ZiGaMi/SleepMonitor2.0_PROJECT_OUTPUTS/README.md

# SleepMonitor2.0_PROJECT_OUTPUTS
Project outputs repository for SleepMonitor 2.0
