ZiGaMi/SleepMonitor2.0_PROJECT_OUTPUTS/PCB/REV2.0/Sleep_Monitor_V2_0_SCH.pdf

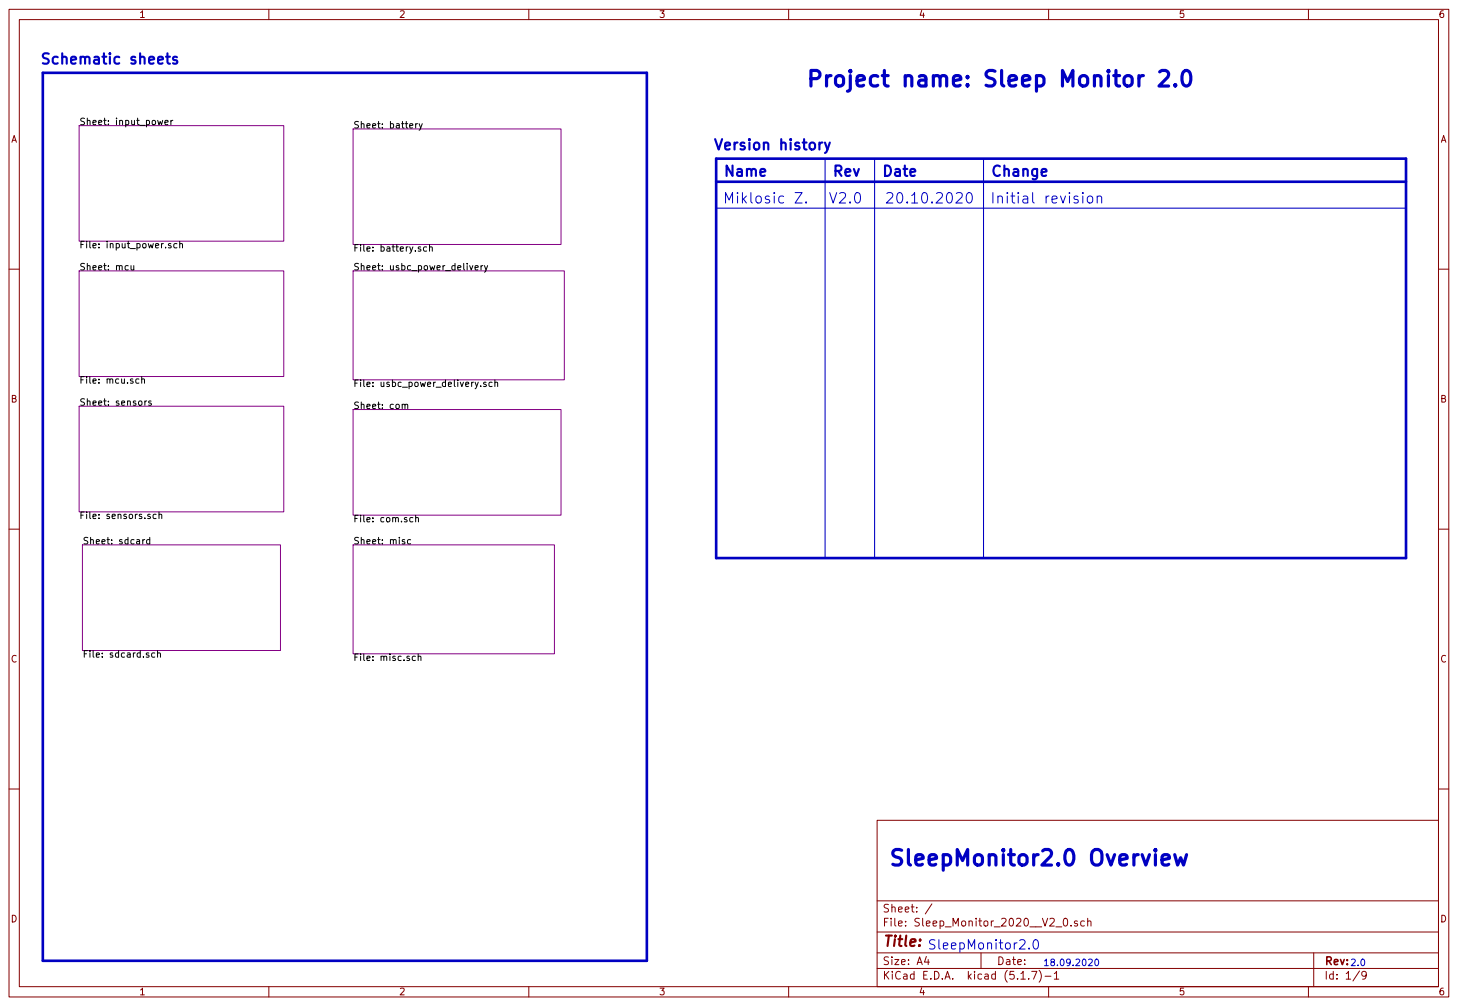
[picture p1: page 1]

Project name: Sleep Monitor 2.0

File: usbc_power_delivery.sch Sheet: com

File: com.sch Sheet: sdcard File: sdcard.sch

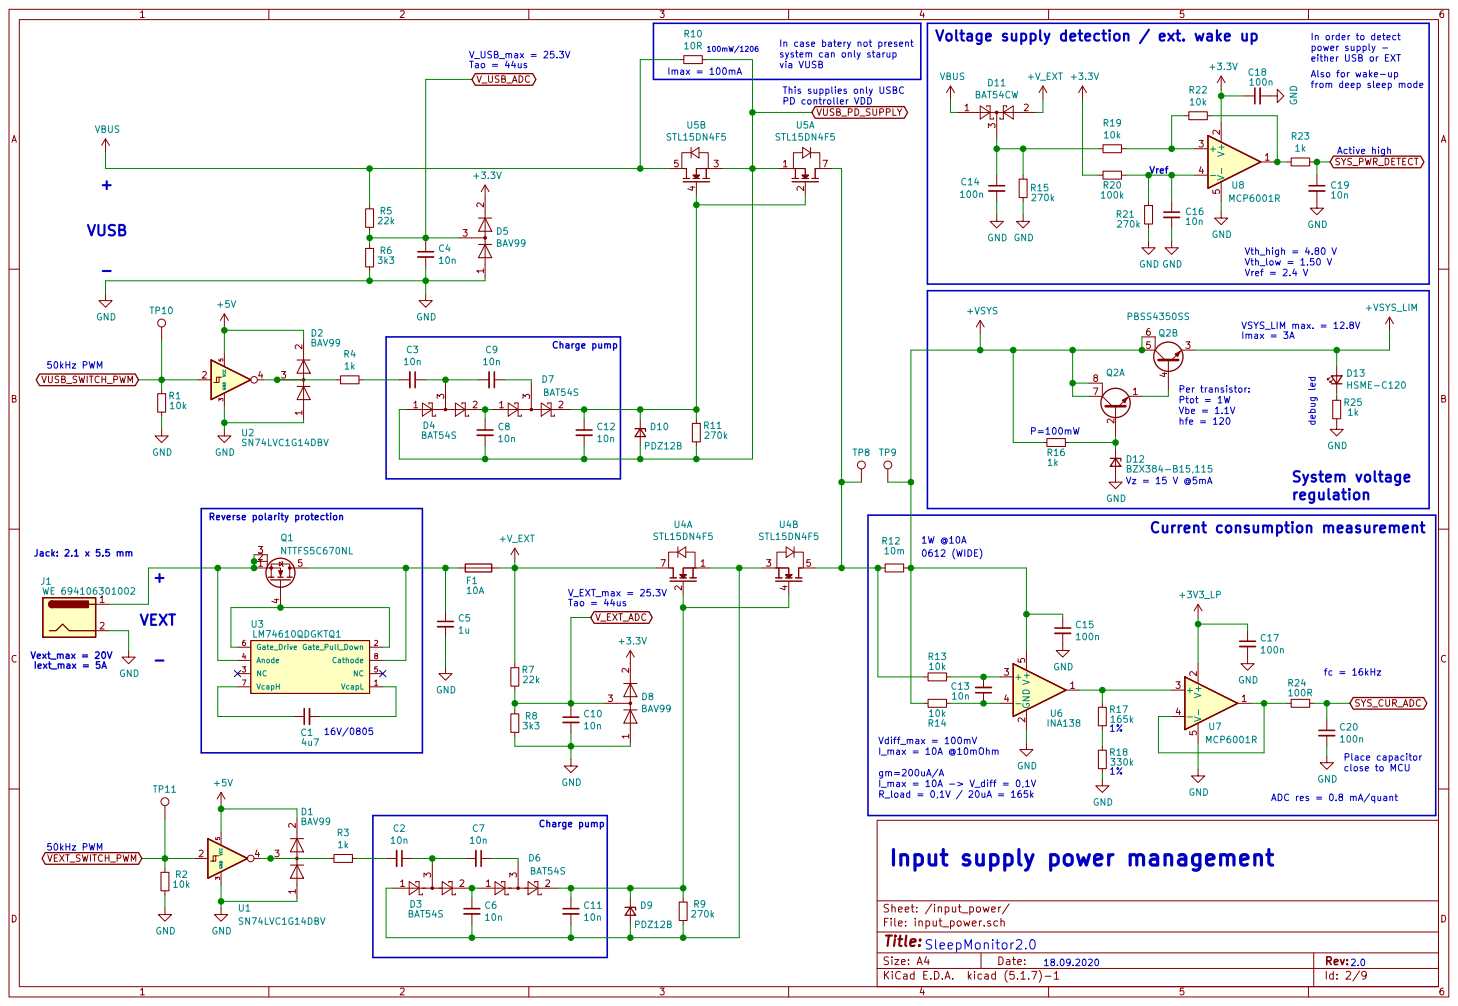
[picture p2: page 2]

In case batery not present
system can only starup
via VUSB

Also for wake-up
from deep sleep mode

This supplies only USBC
PD controller VDD

Place capacitor close to MCU

ADC res = 0.8 mA/quant

Input supply power management

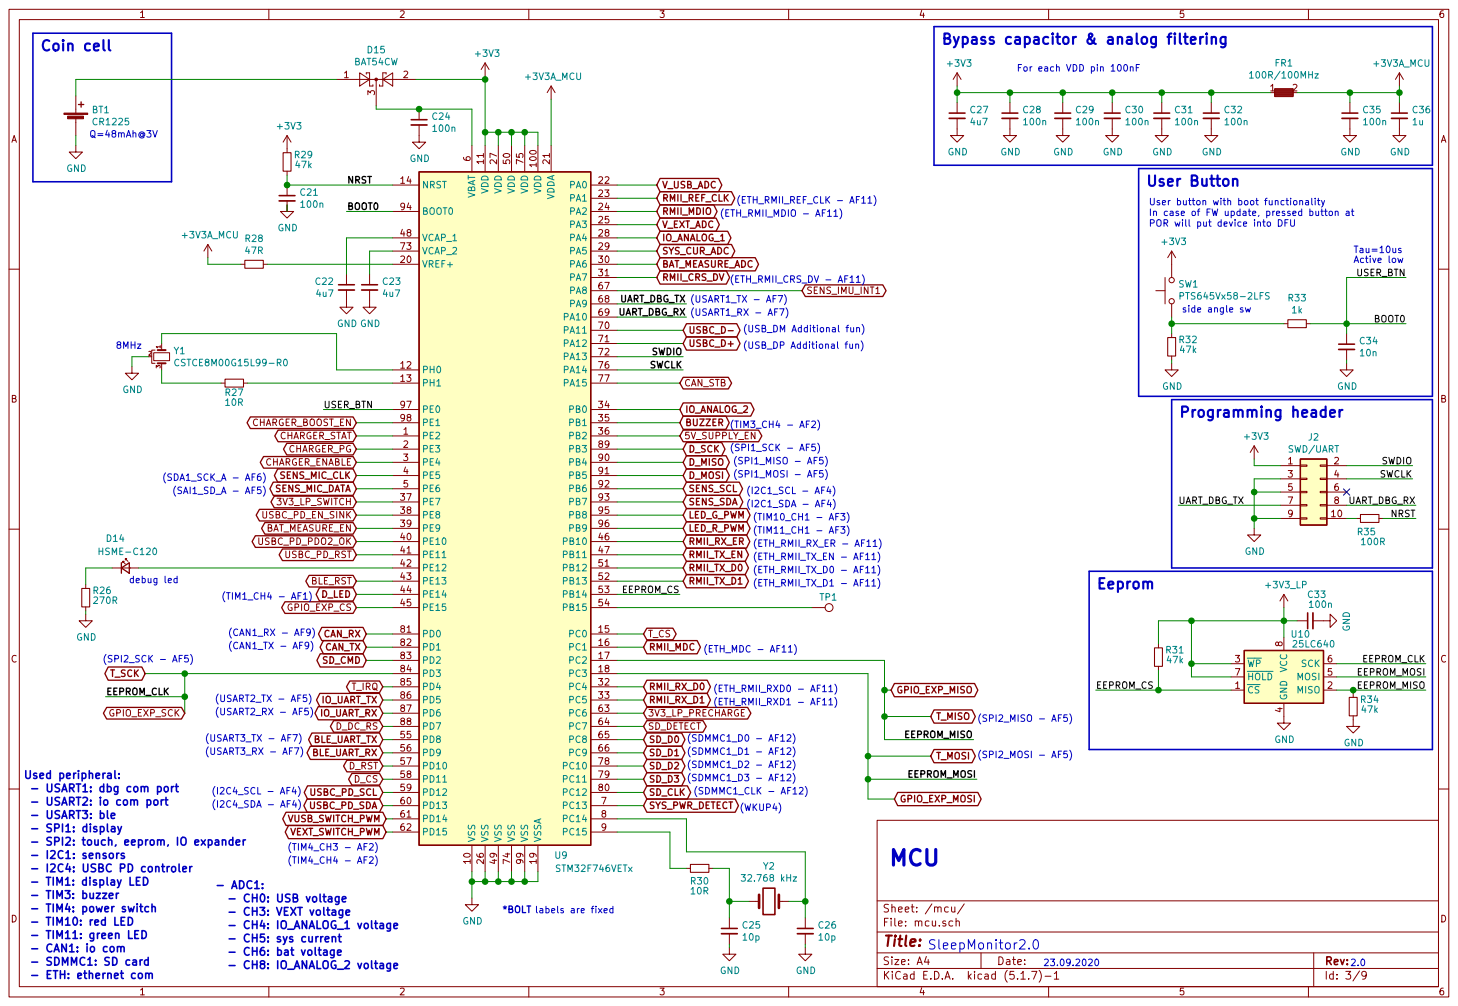
[picture p3: page 3]

Bypass capacitor & analog filtering

For each VDD pin 100nF

6 VCAP_1 48 VCAP_2 73 VDD 100 VDD 11 VDD 27 VDD 50 VDD 75 VDDA 21 VREF+ 20 VSS 10 VSS 26 VSS 49 VSS 74 VSS 99 VSSA 19U9STM32F746VETx

User button with boot functionality
In case of FW update, pressed button at
POR will put device into DFU

4 MOSI 5 SCK 6 HOLD 7 VCC

Used peripheral:
- USART1: dbg com port
- USART2: io com port
- USART3: ble
- SPI1: display
- SPI2: touch, eeprom, IO expander
- I2C1: sensors
- I2C4: USBC PD controler
- TIM1: display LED
- TIM3: buzzer
- TIM4: power switch
- TIM10: red LED
- TIM11: green LED
- CAN1: io com
- SDMMC1: SD card
- ETH: ethernet com

Id: 3/9 Title: File: mcu.sch Sheet: /mcu/
SleepMonitor2.0

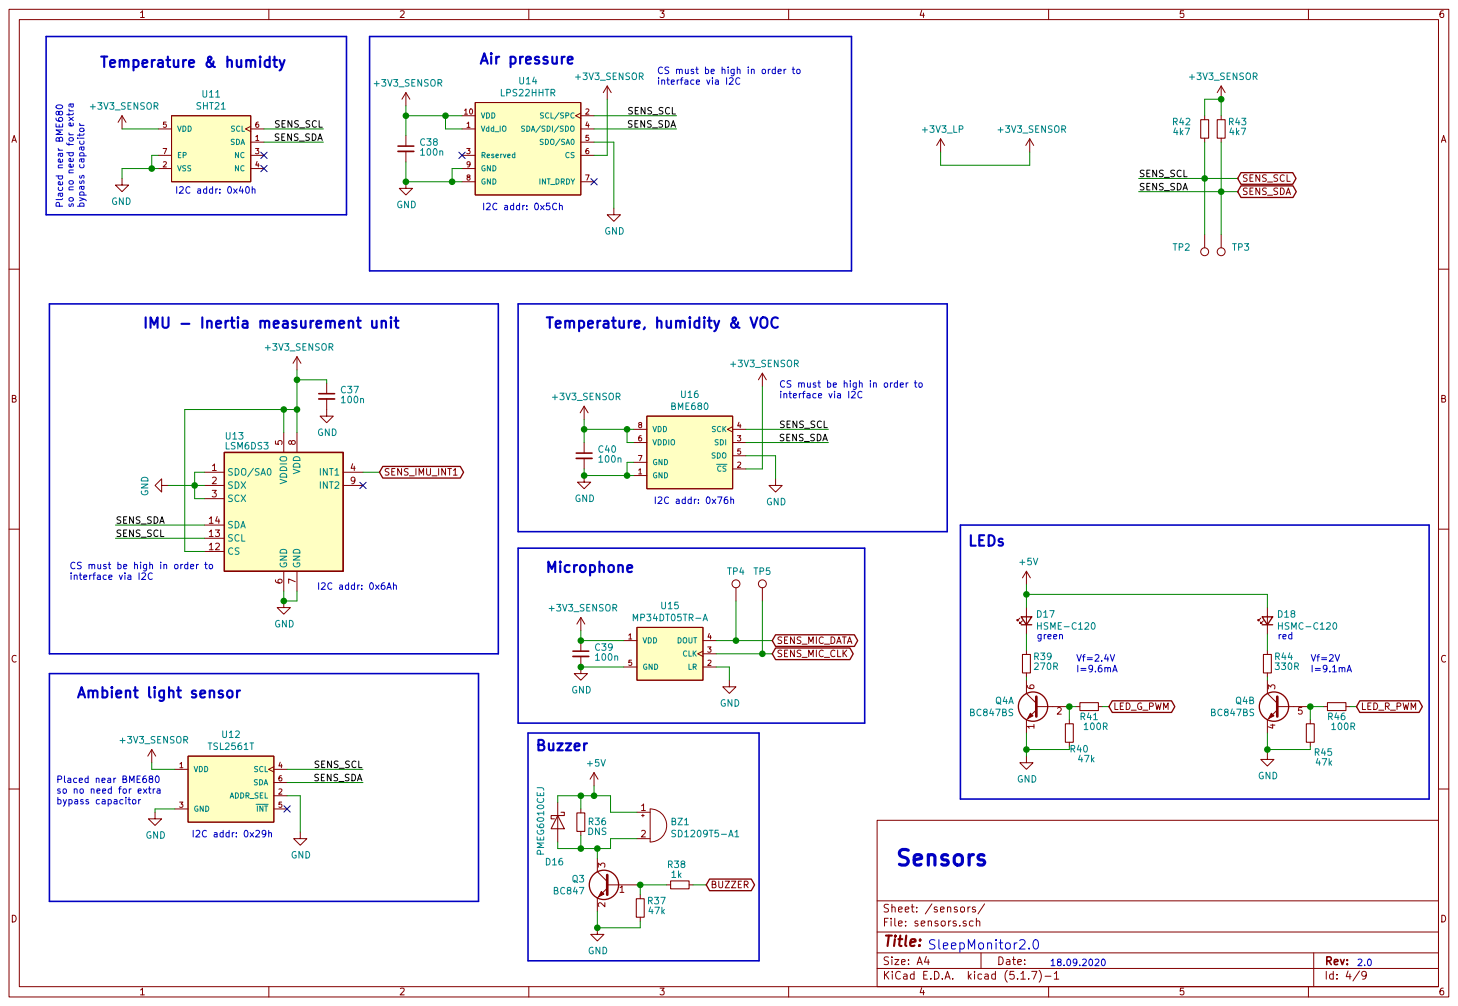
[picture p4: page 4]

interface via I2C Air pressure
+3V3_SENSOR GND

CS must be high in order to

SleepMonitor2.0 Placed near BME680 so no need for extra bypass capacitor Placed near BME680

IMU - Inertia measurement unit

I2C addr: 0x76h Temperature, humidity & VOC

interface via I2C

Ambient light sensor

Sensors | GND Id: 4/9 Title: File: sensors.sch Sheet: /sensors/

so no need for extra
bypass capacitor

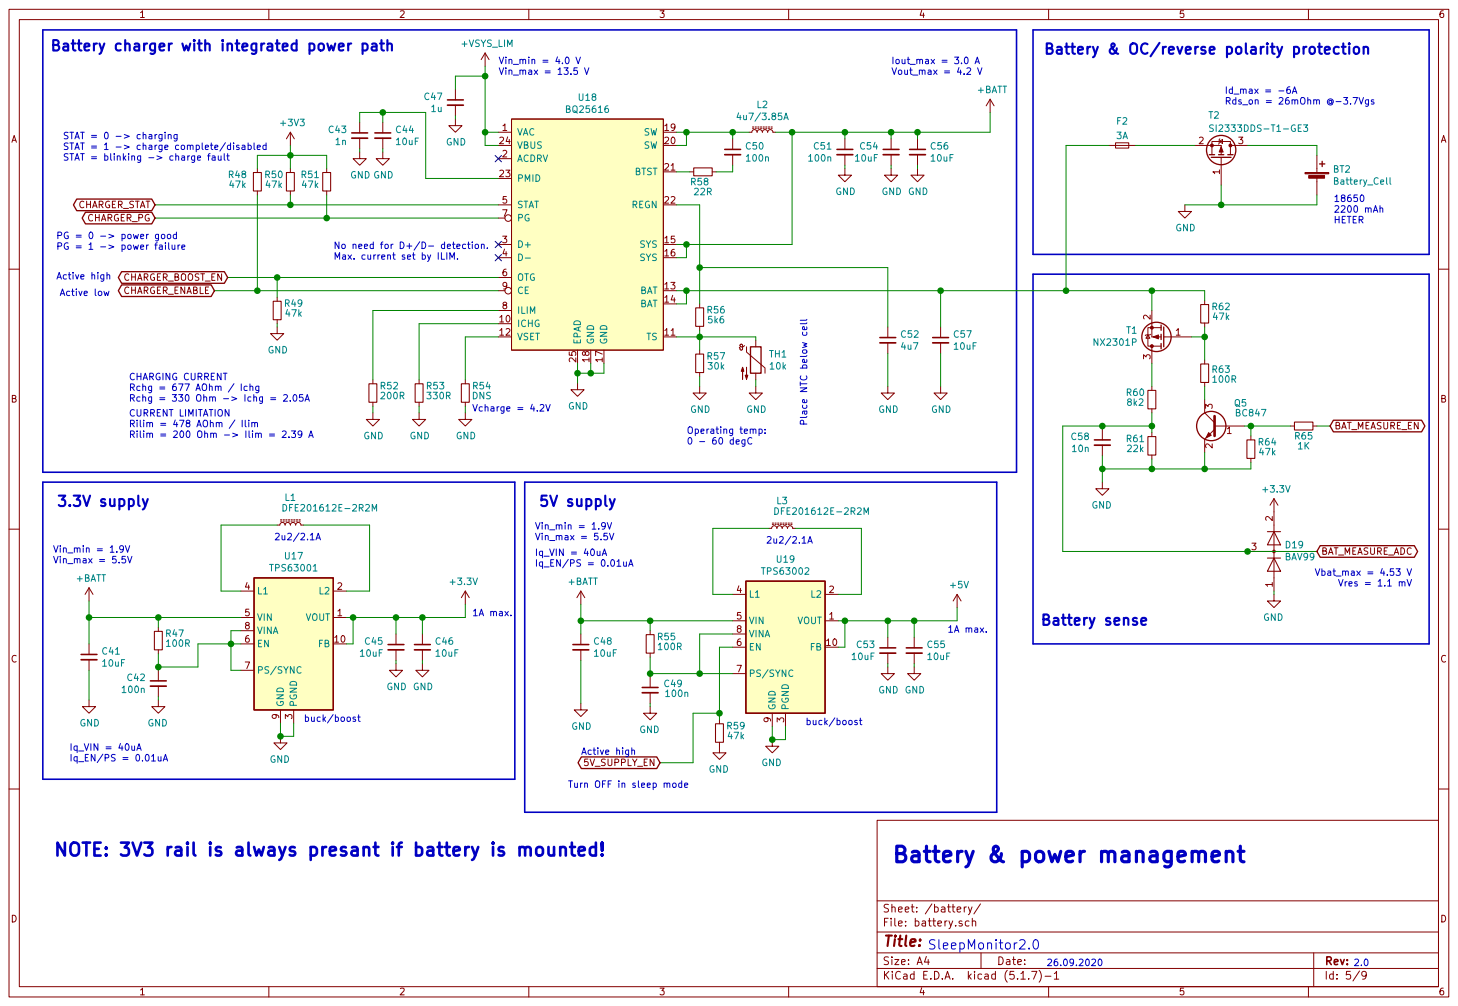
[picture p5: page 5]

Battery charger with integrated power path

Battery & OC/reverse polarity protection Place NTC below cell

STAT = 0 -> charging
STAT = 1 -> charge complete/disabled
STAT = blinking -> charge fault
10uF GND

Vcharge = 4.2V No need for D+/D- detection. Max. current set by ILIM.

Active high Active low

2u2/2.1A CHARGING CURRENT Rchg = 677 AOhm / Ichg

buck/boost Operating temp:
0 - 60 degC

Turn OFF in sleep mode

NOTE: 3V3 rail is always presant if battery is mounted!

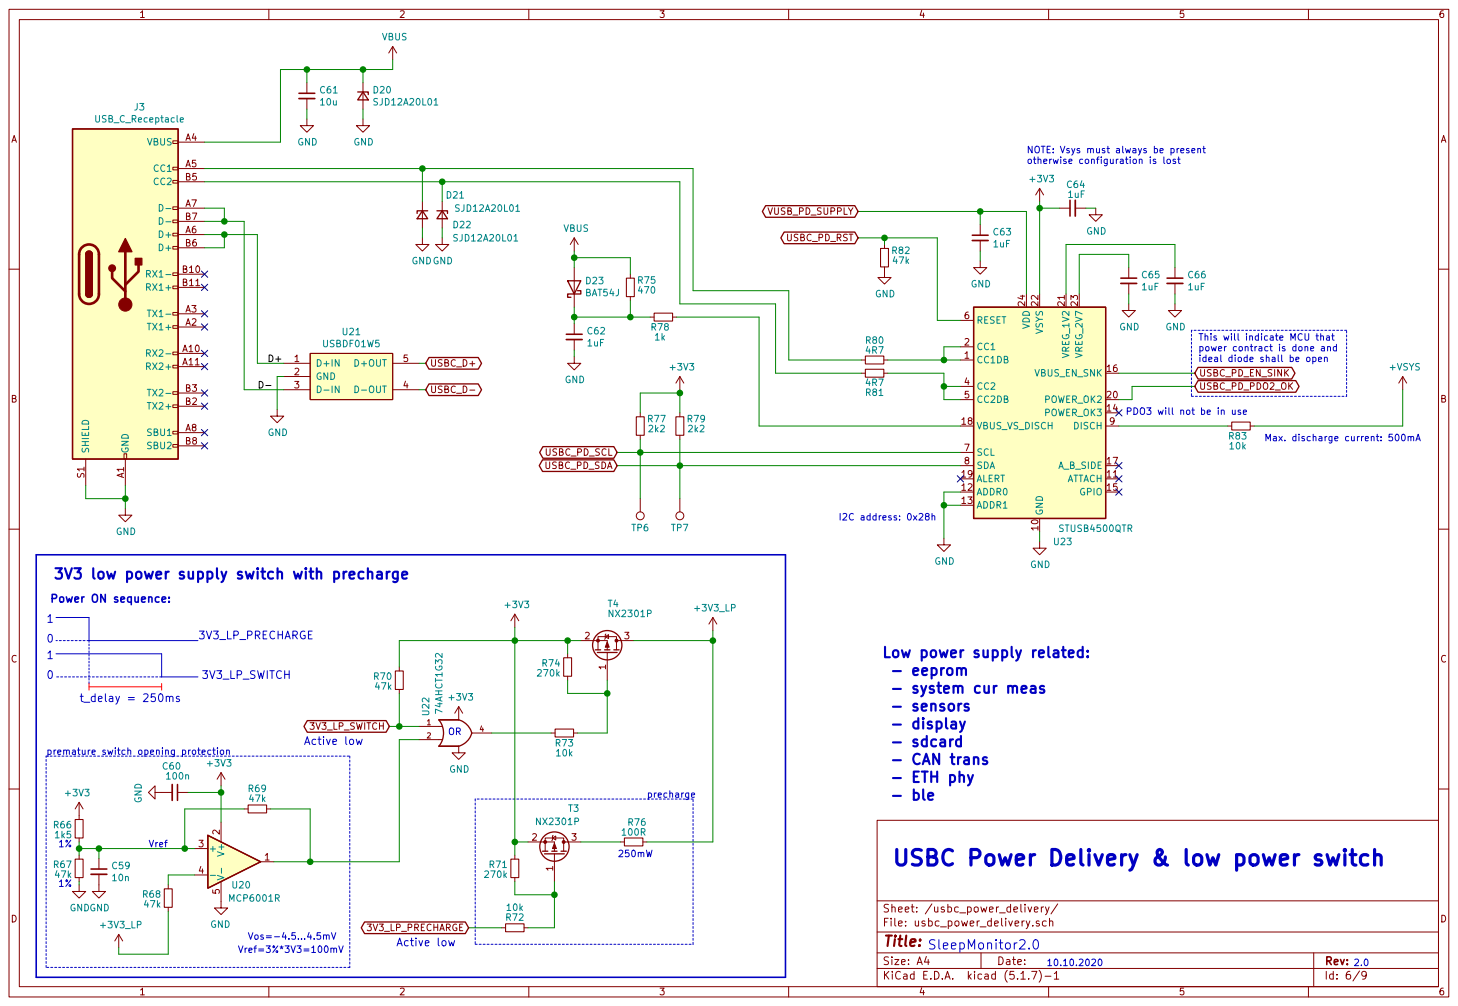
[picture p6: page 6]

NOTE: Vsys must always be present
otherwise configuration is lost

PDO3 will not be in use This will indicate MCU that power contract is done and

ideal diode shall be open

I2C address: 0x28h USBC Power Delivery & low power switch

3V3 low power supply switch with precharge

premature switch opening protection

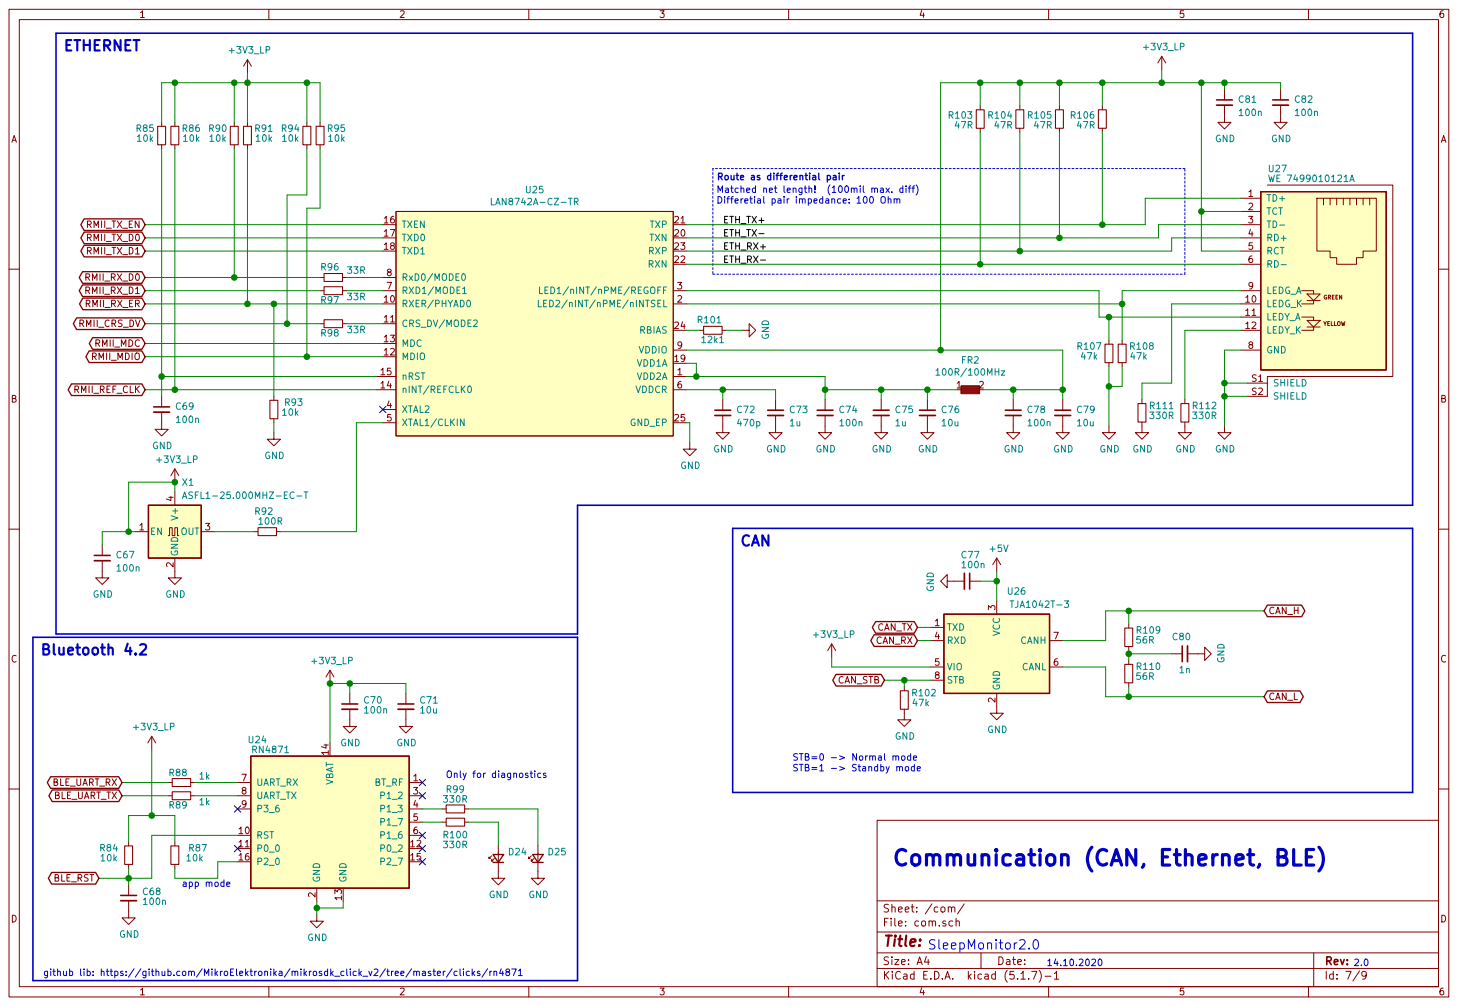
[picture p7: page 7]

Route as differential pair Matched net length! (100mil max. diff) Differetial pair impedance: 100 Ohm

ETH_RX- ETH_TX- ETH_TX+ ETH_RX+

Id: 7/9 Title: File: com.sch Sheet: /com/ GND

3 RXD 4 VIO 5 CANL 6 CANH 7 STB 8 U26TJA1042T-3

2.0 Communication (CAN, Ethernet, BLE)

github lib: https://github.com/MikroElektronika/mikrosdk_click_v2/tree/master/clicks/rn4871

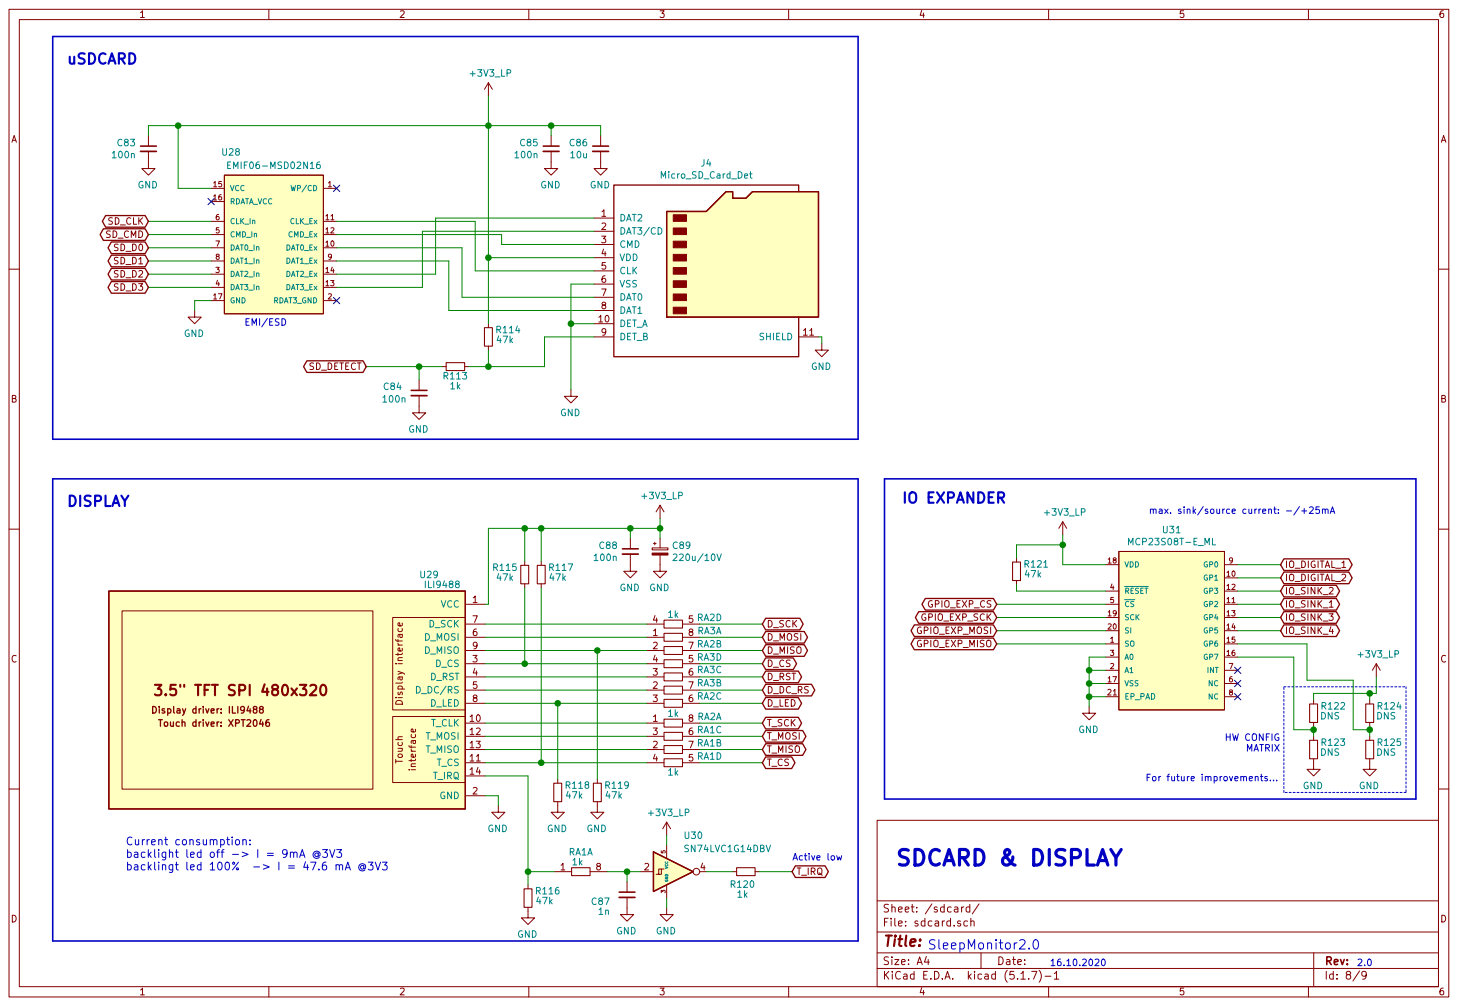
[picture p8: page 8]

Id: 8/9 Title: File: sdcard.sch Sheet: /sdcard/
SleepMonitor2.0

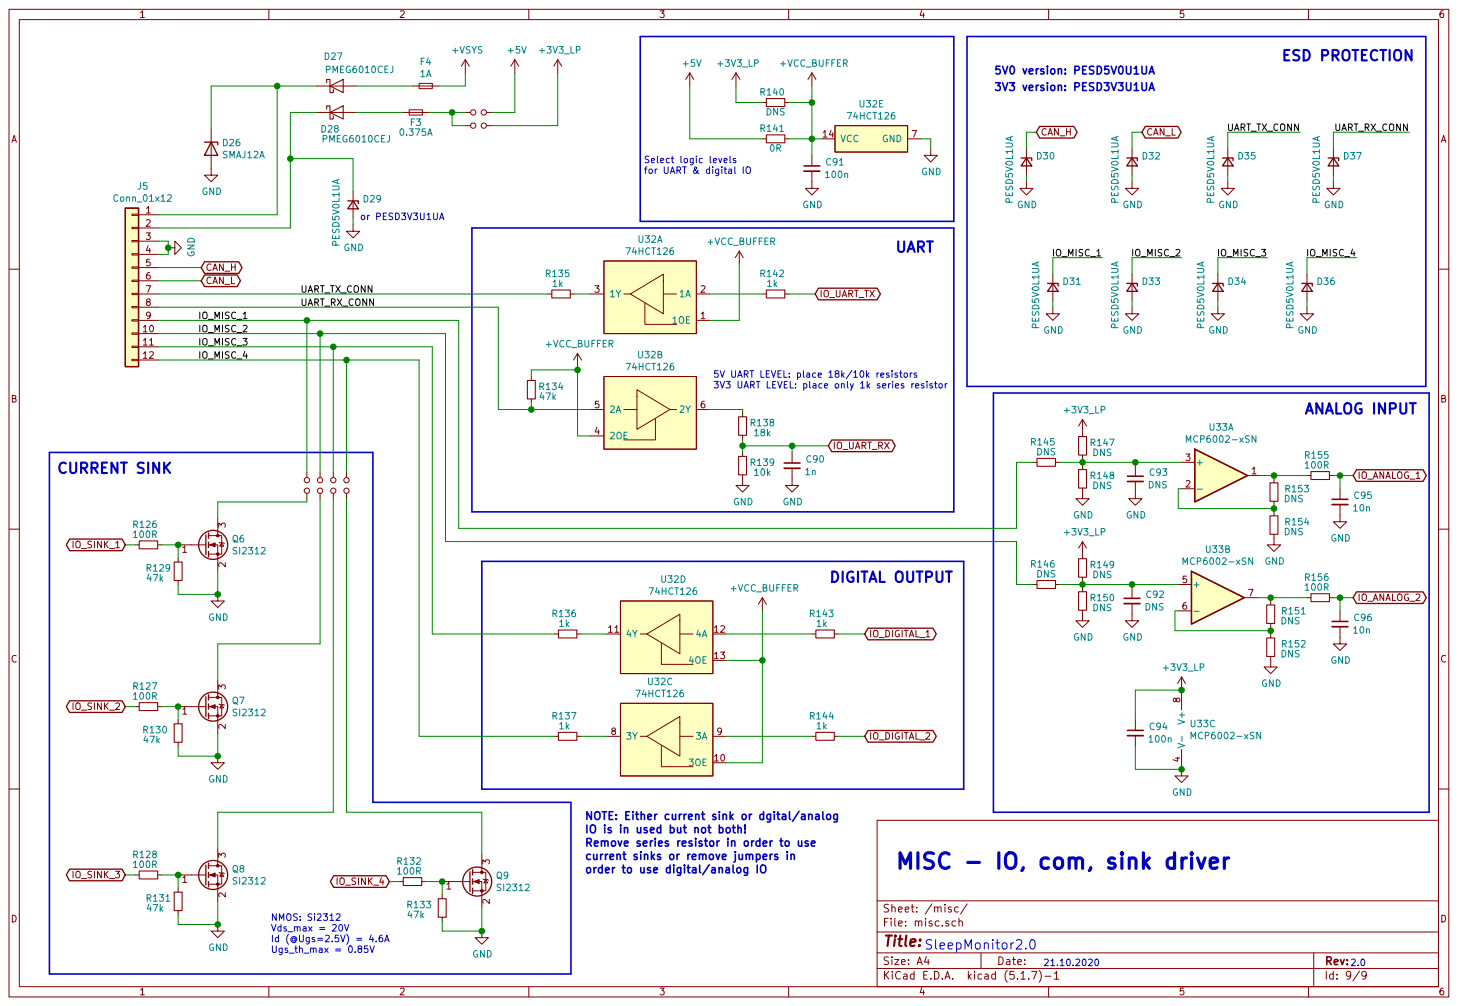
[picture p9: page 9]

Select logic levels
for UART & digital IO

9 IO_MISC_1
10 IO_MISC_2
11 IO_MISC_3
12 IO_MISC_4

5V UART LEVEL: place 18k/10k resistors
3V3 UART LEVEL: place only 1k series resistor

Id: 9/9 Title: File: misc.sch Sheet: /misc/ R137

NOTE: Either current sink or dgital/analog
IO is in used but not both! Remove series resistor in order to use current sinks or remove jumpers in

MISC - IO, com, sink driver

order to use digital/analog IO
